jakplugg/Monsoon/README.md

# Monsoon
Monsoon Is a variation of mutable instruments clouds with separate CV and controls for the 4 "blend" functions.

12Hp eurorack module.

The 4 LEDs on the sliders indicate incoming control voltage for the 4 main parameters, this is done in hardware, with 4 LM321 op amps. 

The slider LEDs are normal "one way" and only display positive CV input, if you would prefer to see bipolar (negative as well) you can replace the rectangular LEDs in the sliders with bidirectional round 3mm red/green or any other 2 color LED, the leg spacing is the same. you simply pull up on the LEDs and they come out. (do not let cats or small children know that!)

The slider LEDs do not display slider value, just the CV input.

The button which used to select blend parameters now simply switches what the 4 LEDs display between audio input monitoring and monitoring the 4 blend amounts.

[Stock clouds, Clouds Parasites, and Jkammerl beat repeat Firmwares modified for Monsoon by Tom Burns:](https://github.com/boourns/eurorack/releases/tag/monsoon_firmwares_v1)

[Google sheet BOM (in progress):](https://docs.google.com/spreadsheets/d/1RgaPN_YdO_VuwdeUBHkcrlwIOgGYM_RJl-FyqPO2IpU/edit?usp=sharing)

JM.
