jakplugg/Monsoon/panel_key.pdf

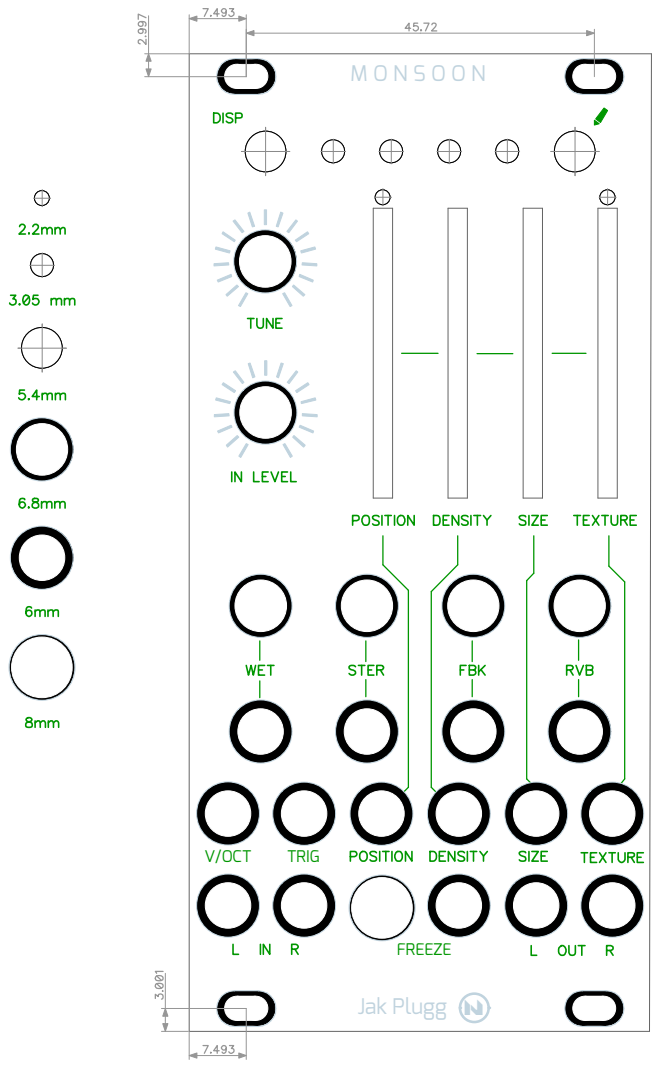
[picture p1: page 1]
Jak Plugg; V/OCT; FREEZE; TRIG
