jakplugg/Monsoon/MonsoonSheet1.pdf

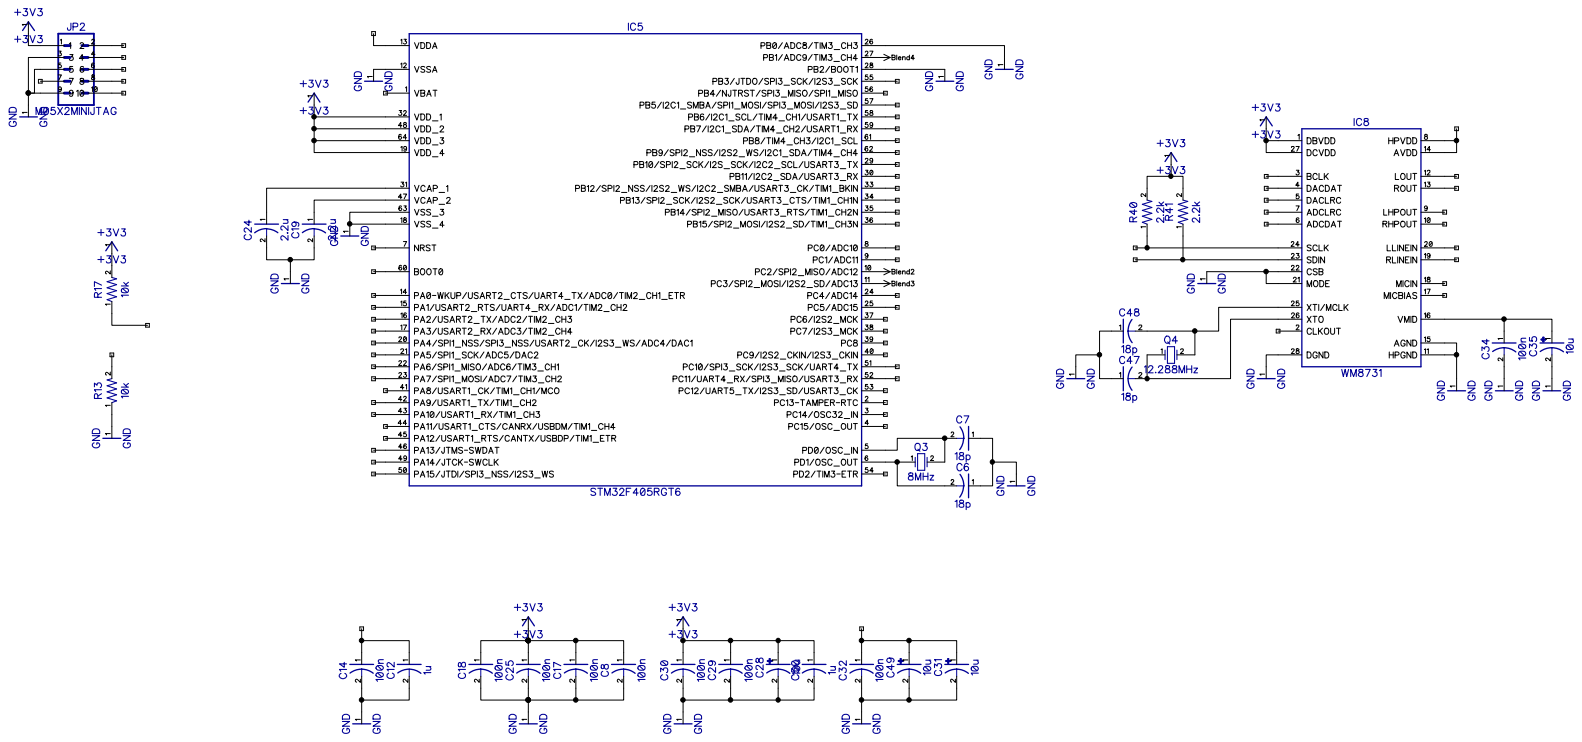
[picture p2: page 1]
