jakplugg/Monsoon/MonsoonSheet2.pdf

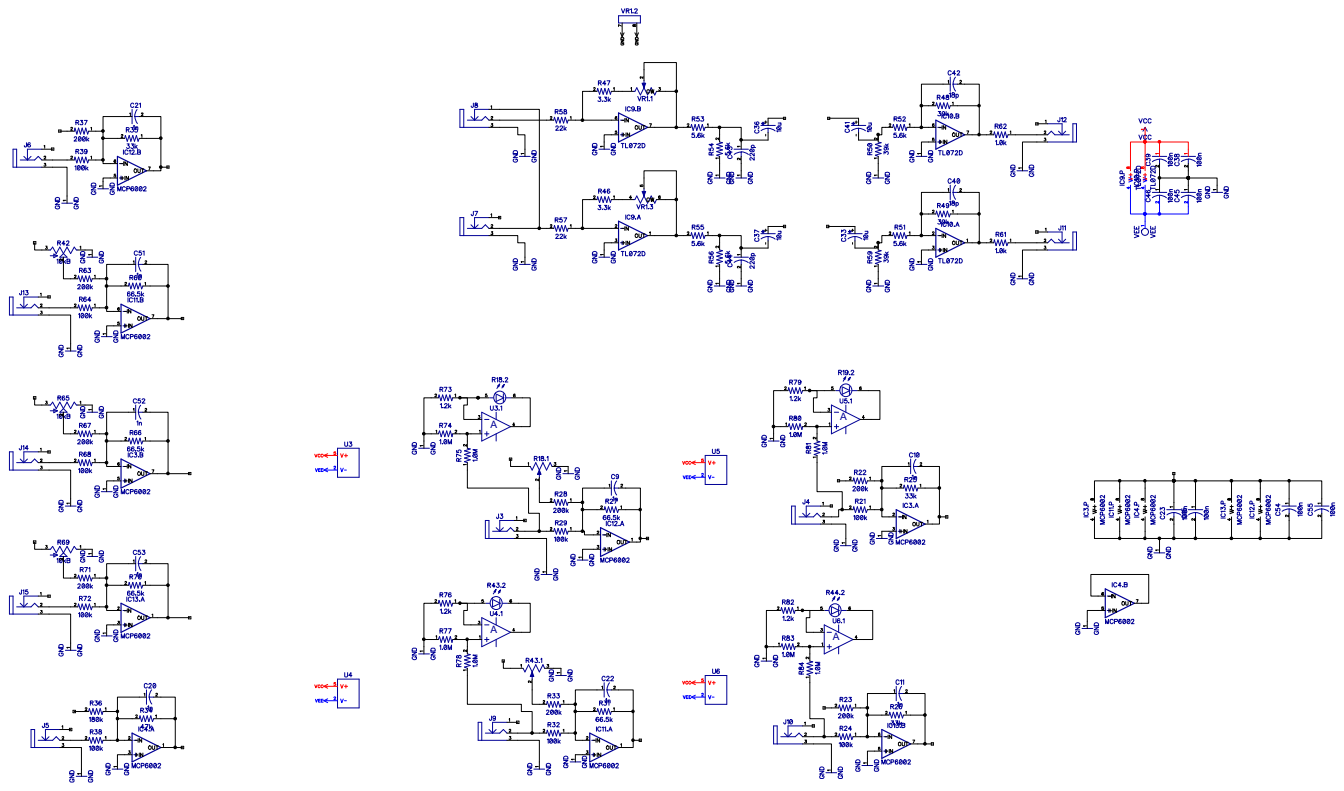
[picture p3: page 1]
