jakplugg/Monsoon/MonsoonSheet3.pdf

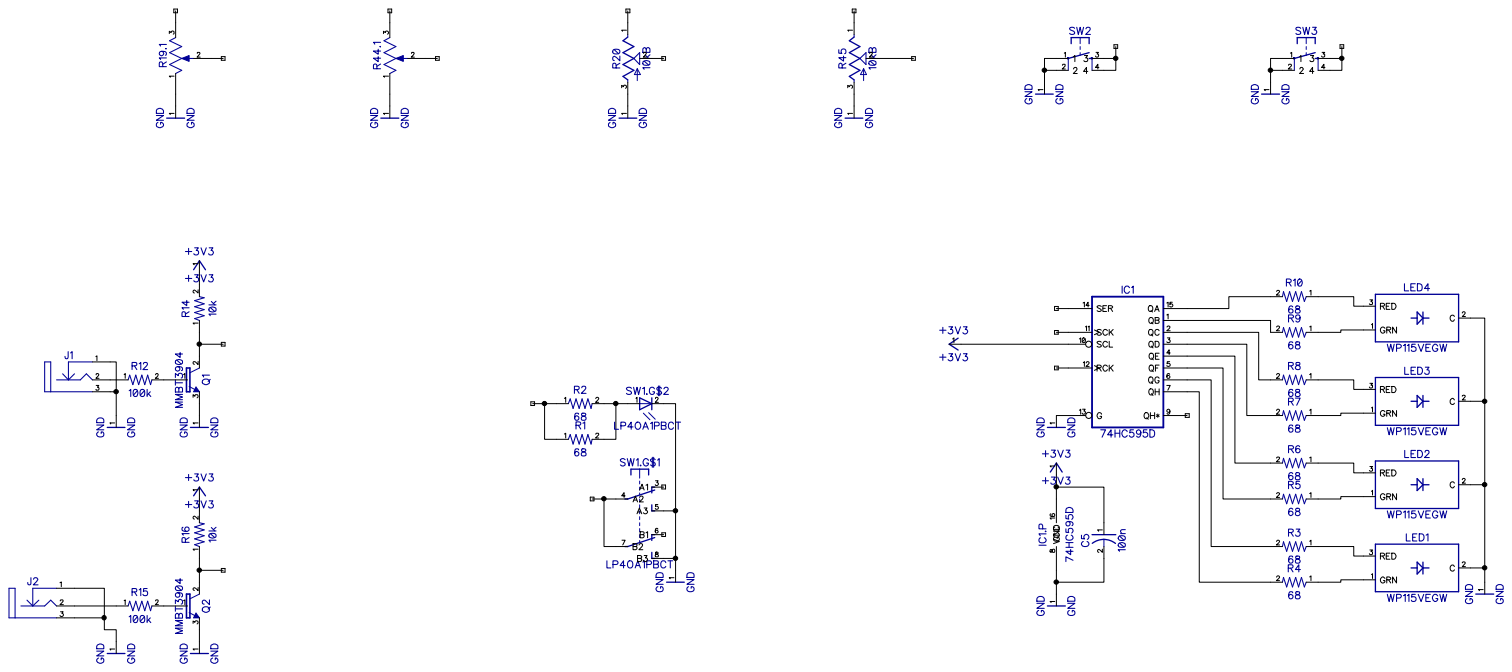
[picture p4: page 1]
