jakplugg/Monsoon/MonsoonSheet4.pdf

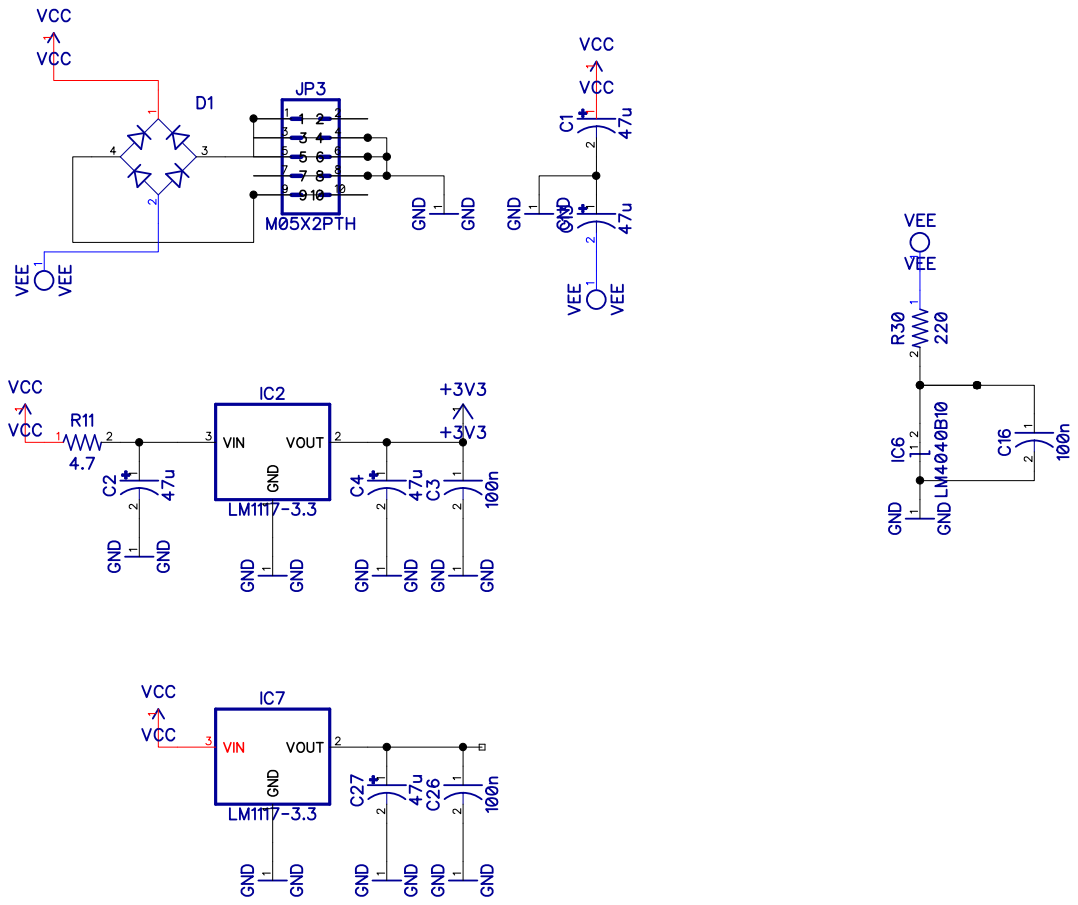
[picture p5: page 1]
