jakplugg/Monsoon/(list of files, drawings)

Other design files:
monsoon.dch
monsooon_01.dip
monsooon_panel.dip
monsooon_panel_key.dip
