jakplugg/Monsoon/eagle_export_sch.sch

## EAGLE design eagle_export_sch.sch (2018-12-09)

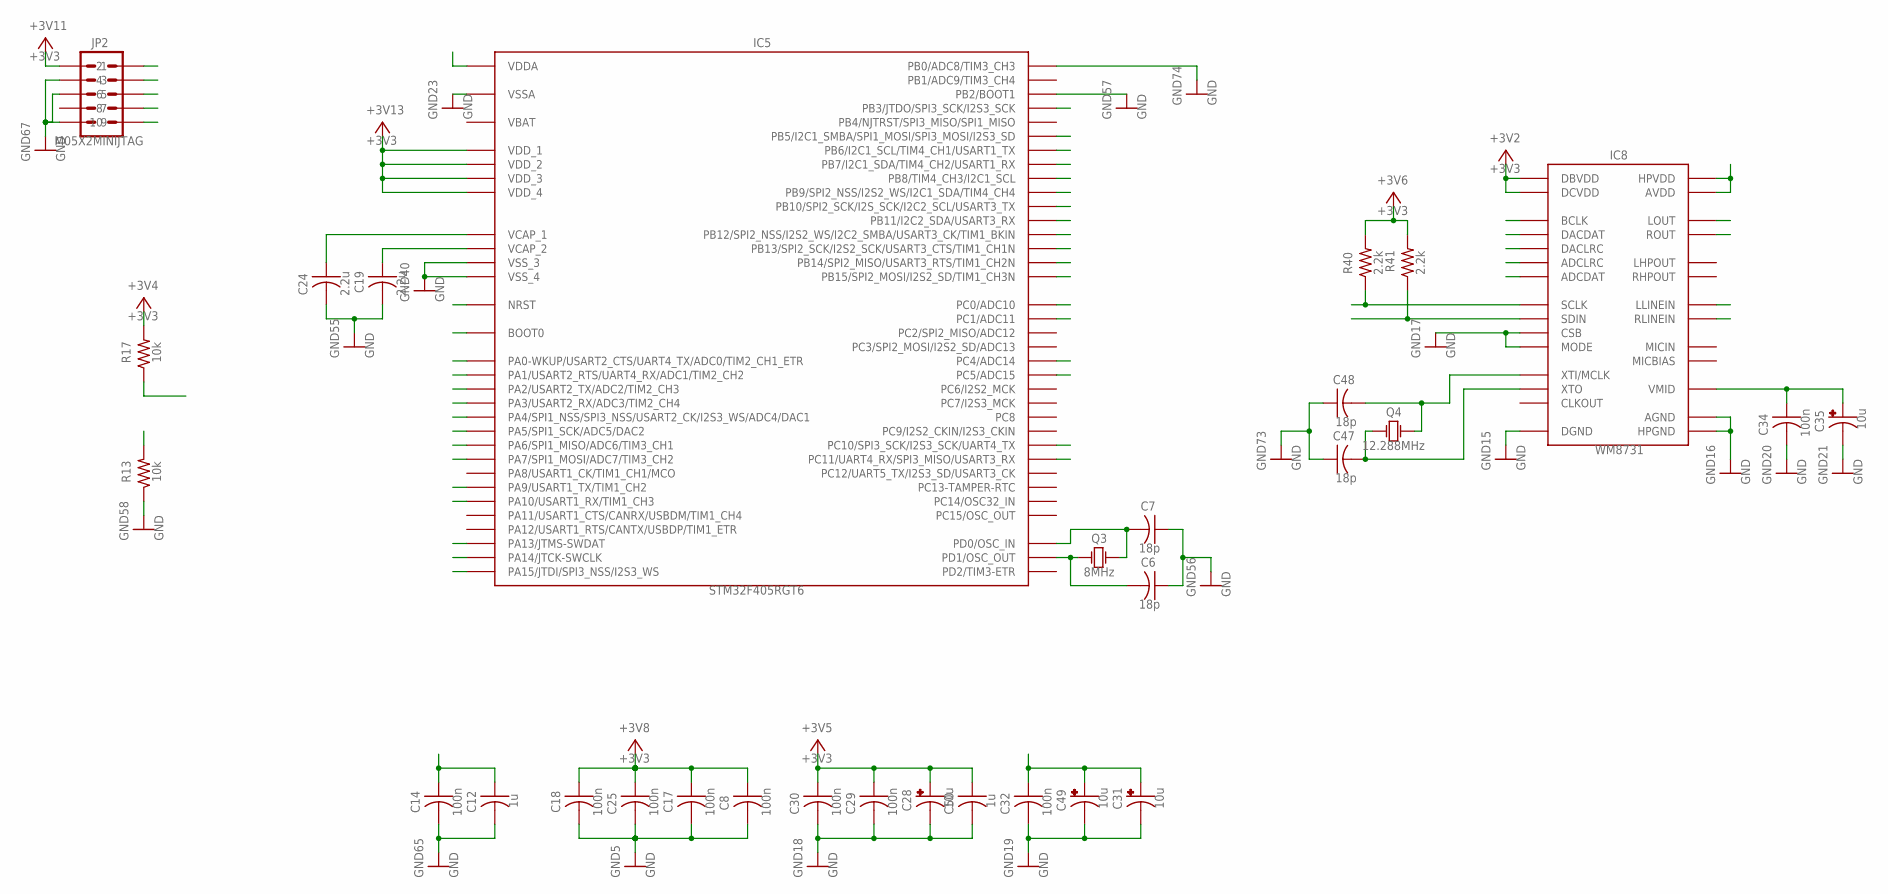
[picture p6: schematic eagle_export_sch.sch, sheet 1]

Parts:
C6, C7, C47, C48: 18p; CAP_0603
C8, C14, C17, C18, C25, C29, C30, C32, C34: 100n; CAP_0603
C12, C50: 1u; CAP_0603
C19, C24: 2.2u; CAP_0805
C28, C49: 10u; PANASONIC_A
C31, C35: 10u; PANASONIC_B
IC5: STM32F405RGT6; TQFP-10X10-64
IC8: WM8731; SSOP28
JP2: M05X2MINIJTAG; 2X5-1.27
Q3: 8MHz; TSC_7A_crystal
Q4: 12.288MHz; TSC_7A_crystal
R13, R17: 10k; RES_0603
R40, R41: 2.2k; RES_0603

Connections:
+3V3: C8.1, C17.1, C18.1, C25.1, C28.+, C29.1, C30.1, C50.1, IC5.19 (VDD_4), IC5.32 (VDD_1), IC5.48 (VDD_2), IC5.64 (VDD_3), IC8.1 (DBVDD), IC8.27 (DCVDD), JP2.1, R17.2, R40.2, R41.2
+3V3_A: C12.1, C14.1, C31.+, C32.1, C49.+, IC5.13 (VDDA), IC8.8 (HPVDD), IC8.14 (AVDD)
BLEND_CV: IC5.21 (PA5/SPI1_SCK/ADC5/DAC2)
BLEND_POT: IC5.23 (PA7/SPI1_MOSI/ADC7/TIM3_CH2)
BOOT_FLASH: IC5.60 (BOOT0), R13.2
Blend2: IC5.10 (PC2/SPI2_MISO/ADC12)
Blend3: IC5.11 (PC3/SPI2_MOSI/I2S2_SD/ADC13)
Blend4: IC5.27 (PB1/ADC9/TIM3_CH4)
DENSITY_CV: IC5.17 (PA3/USART2_RX/ADC3/TIM2_CH4)
GND: C6.1, C7.1, C8.2, C12.2, C14.2, C17.2, C18.2, C19.2, C24.2, C25.2, C28.-, C29.2, C30.2, C31.-, C32.2, C34.2, C35.-, C47.1, C48.1, C49.-, C50.2, IC5.12 (VSSA), IC5.18 (VSS_4), IC5.26 (PB0/ADC8/TIM3_CH3), IC5.28 (PB2/BOOT1), IC5.63 (VSS_3), IC8.11 (HPGND), IC8.15 (AGND), IC8.21 (MODE), IC8.22 (CSB), IC8.28 (DGND), JP2.3, JP2.5, JP2.9, R13.1
I2C_SCL: IC5.29 (PB10/SPI2_SCK/I2S_SCK/I2C2_SCL/USART3_TX), IC8.24 (SCLK), R40.1
I2C_SDA: IC5.30 (PB11/I2C2_SDA/USART3_RX), IC8.23 (SDIN), R41.1
I2S_LRCK: IC5.33 (PB12/SPI2_NSS/I2S2_WS/I2C2_SMBA/USART3_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), IC8.5 (DACLRC), IC8.7 (ADCLRC)
I2S_SCK: IC5.34 (PB13/SPI2_SCK/I2S2_SCK/USART3_CTS/TIM1_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), IC8.3 (BCLK)
I2S_SIN: IC5.35 (PB14/SPI2_MISO/USART3_RTS/TIM1_CH2N), IC8.6 (ADCDAT)
I2S_SOUT: IC5.36 (PB15/SPI2_MOSI/I2S2_SD/TIM1_CH3N), IC8.4 (DACDAT)
JTCK: IC5.49 (PA14/JTCK-SWCLK), JP2.4
JTDI: IC5.50 (PA15/JTDI/SPI3_NSS/I2S3_WS), JP2.8
JTDO: IC5.55 (PB3/JTDO/SPI3_SCK/I2S3_SCK), JP2.6
JTMS: IC5.46 (PA13/JTMS-SWDAT), JP2.2
LED_DATA: IC5.57 (PB5/I2C1_SMBA/SPI1_MOSI/SPI3_MOSI/I2S3_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)
LED_EN: IC5.24 (PC4/ADC14)
LED_REC: IC5.62 (PB9/SPI2_NSS/I2S2_WS/I2C1_SDA/TIM4_CH4)
LED_SCK: IC5.25 (PC5/ADC15)
LIN: IC8.20 (LLINEIN)
LOUT: IC8.12 (LOUT)
unnamed: C7.2, IC5.5 (PD0/OSC_IN), Q3.2 (OSC2)
unnamed: C6.2, IC5.6 (PD1/OSC_OUT), Q3.1 (OSC1)
unnamed: C19.1, IC5.47 (VCAP_2)
unnamed: C34.1, C35.+, IC8.16 (VMID)
unnamed: C24.1, IC5.31 (VCAP_1)
unnamed: C47.2, IC8.26 (XTO), Q4.1 (OSC1)
unnamed: C48.2, IC8.25 (XTI/MCLK), Q4.2 (OSC2)
PITCH_POT: IC5.9 (PC1/ADC11)
PLAY: IC5.58 (PB6/I2C1_SCL/TIM4_CH1/USART1_TX)
POSITION_POT_CV: IC5.16 (PA2/USART2_TX/ADC2/TIM2_CH3)
REC: IC5.59 (PB7/I2C1_SDA/TIM4_CH2/USART1_RX)
RESET: IC5.7 (NRST), JP2.10, R17.1
RIN: IC8.19 (RLINEIN)
ROUT: IC8.13 (ROUT)
RX: IC5.43 (PA10/USART1_RX/TIM1_CH3)
SIZE_CV: IC5.15 (PA1/USART2_RTS/UART4_RX/ADC1/TIM2_CH2)
SIZE_POT: IC5.8 (PC0/ADC10)
SW_LOAD: IC5.51 (PC10/SPI3_SCK/I2S3_SCK/UART4_TX)
SW_MODE: IC5.52 (PC11/UART4_RX/SPI3_MISO/USART3_RX)
SW_REC: IC5.61 (PB8/TIM4_CH3/I2C1_SCL)
TEXTURE_CV: IC5.14 (PA0-WKUP/USART2_CTS/UART4_TX/ADC0/TIM2_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)
TEXTURE_POT: IC5.22 (PA6/SPI1_MISO/ADC6/TIM3_CH1)
TX: IC5.42 (PA9/USART1_TX/TIM1_CH2)
V_OCT: IC5.20 (PA4/SPI1_NSS/SPI3_NSS/USART2_CK/I2S3_WS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)

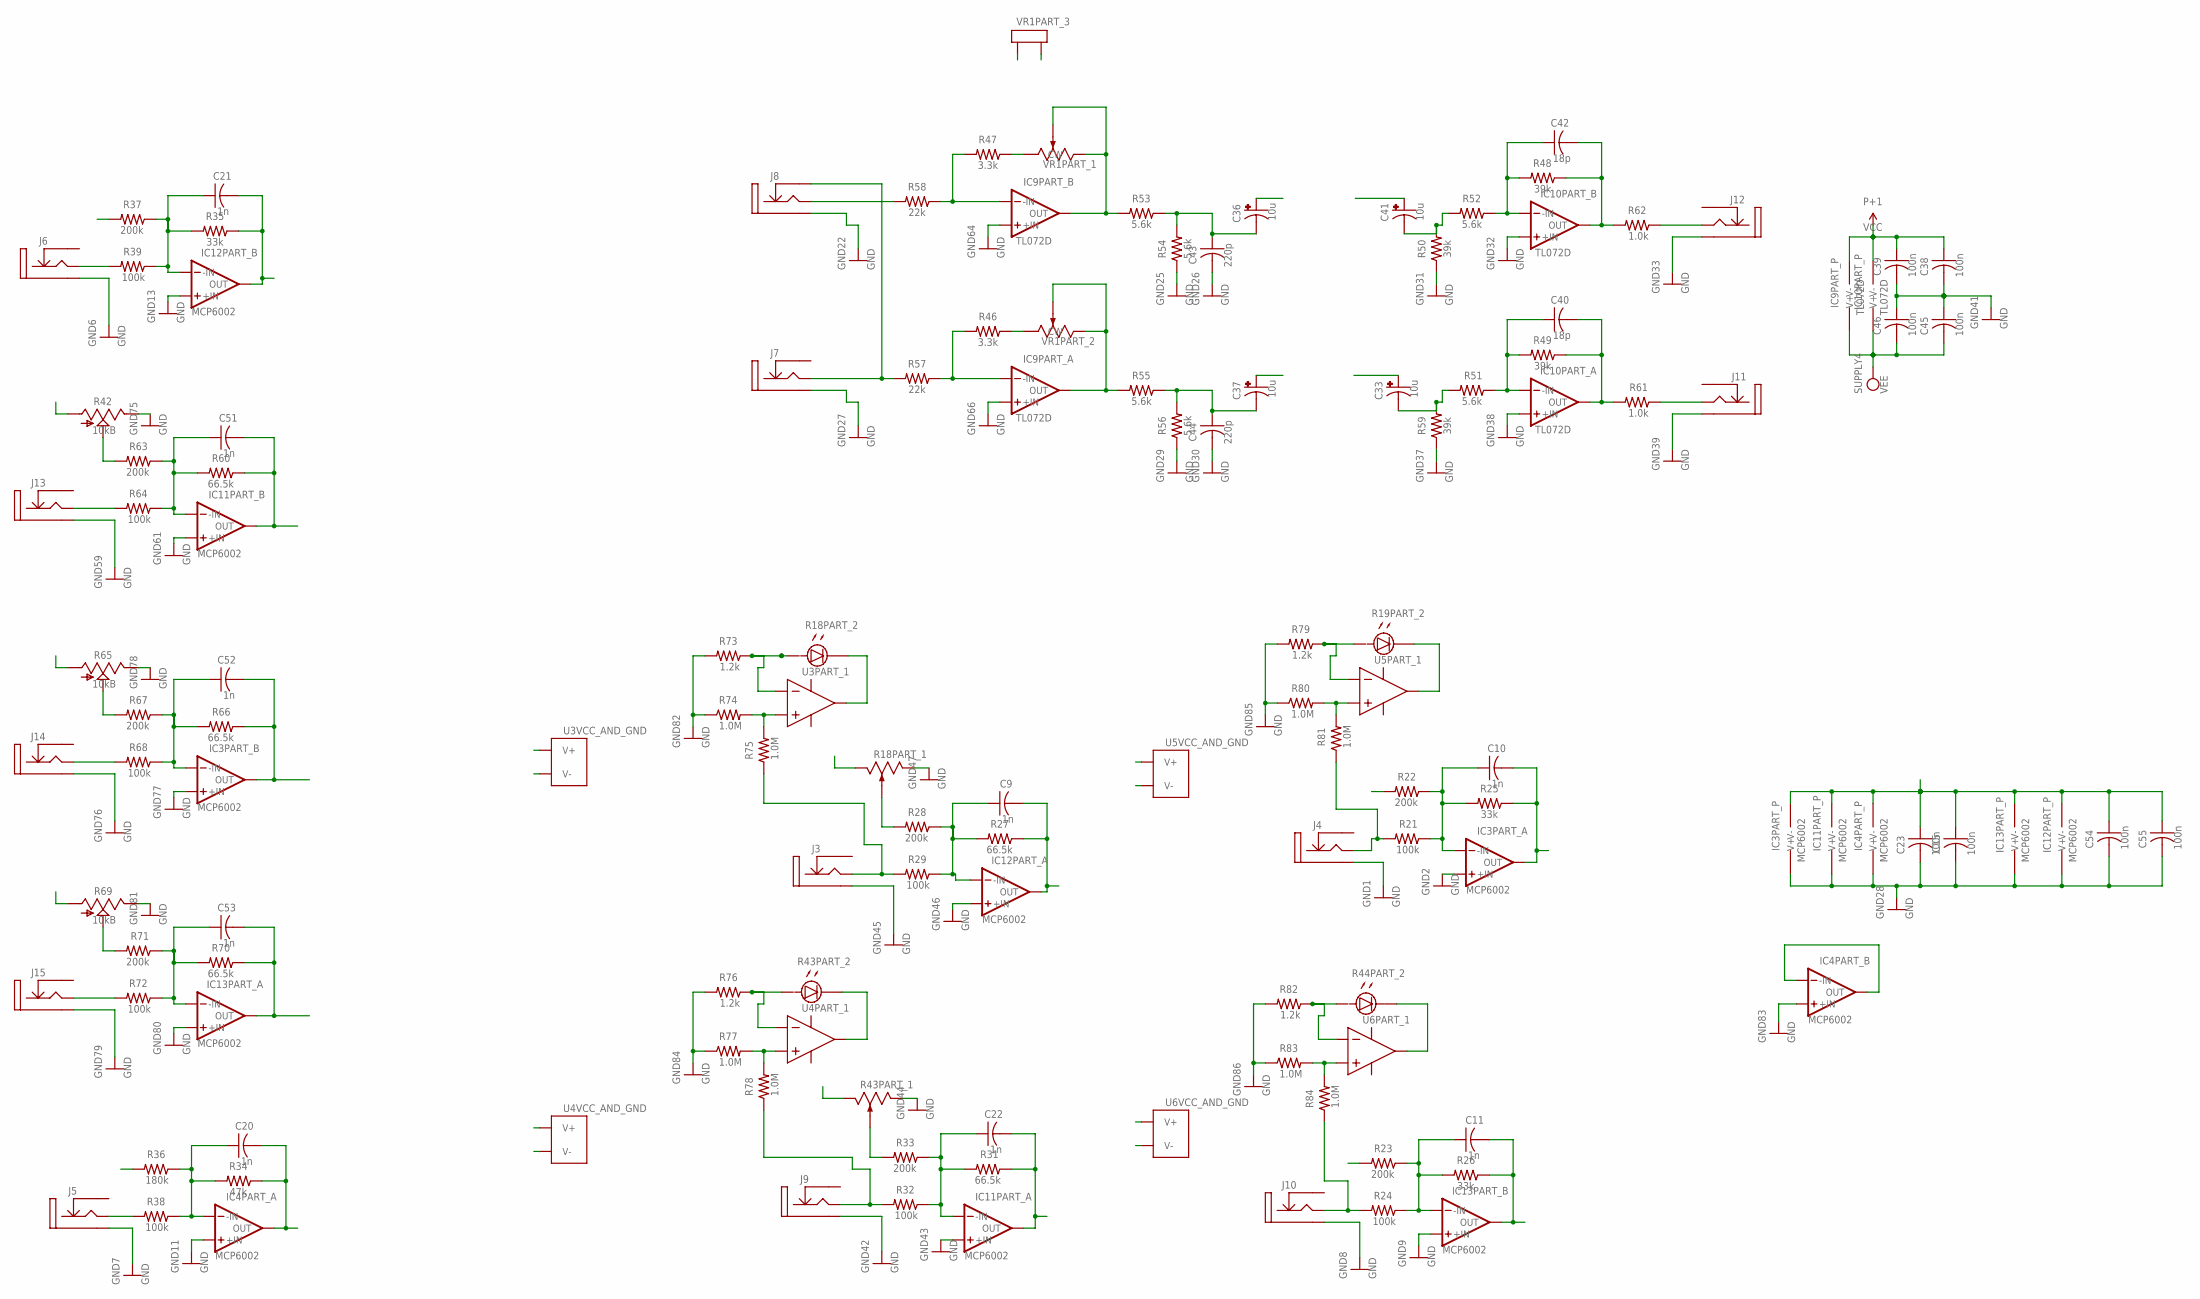
[picture p7: schematic eagle_export_sch.sch, sheet 2]

Parts:
C9, C10, C11, C20, C21, C22, C51, C52, C53: 1n; CAP_0603
C15, C23, C38, C39, C45, C46, C54, C55: 100n; CAP_0603
C33, C36, C37, C41: 10u; PANASONIC_A
C40, C42: 18p; CAP_0603
C43, C44: 220p; CAP_0603
IC3, IC4, IC11, IC12, IC13: MCP6002; SOIC-8/150mil
IC9, IC10: TL072D; SOIC-8/150mil
J3, J4, J5, J6, J7, J8, J9, J10, J13, J14, J15: THONKICONN; Thonkiconn_Jack
J11, J12: THONKICONN_33; Thonkiconn_Jack
R18, R19, R43, R44: BOURNS_PTL_LED_SLIDE_POT; BOURNS_PTL_30mm
R21, R24, R29, R32, R38, R39, R64, R68, R72: 100k; RES_0603
R22, R23, R28, R33, R37, R63, R67, R71: 200k; RES_0603
R25, R26, R35: 33k; RES_0603
R27, R31, R60, R66, R70: 66.5k; RES_0603
R34: 47k; RES_0603
R36: 180k; RES_0603
R42, R65, R69: 10kB; ALPS_POT_VERTICAL_PS
R46, R47: 3.3k; RES_0603
R48, R49, R50, R59: 39k; RES_0603
R51, R52, R53, R54, R55, R56: 5.6k; RES_0603
R57, R58: 22k; RES_0603
R61, R62: 1.0k; RES_0603
R73, R76, R79, R82: 1.2k; RES_0603
R74, R75, R77, R78, R80, R81, R83, R84: 1.0M; RES_0603
U3, U4, U5, U6: LM321MF; SOT23-5
VR1: ALPS_DUAL_POT_9MM; ALPS_dual_pot

Connections:
+3V3_A: C15.1, C23.1, C54.1, C55.1, IC3.8 (V+), IC4.8 (V+), IC11.8 (V+), IC12.8 (V+), IC13.8 (V+)
AREF_-10: R18.1 (CCW), R22.2, R23.2, R36.2, R37.2, R42.P$3 (A), R43.1 (CCW), R65.P$3 (A), R69.P$3 (A)
BLEND_CV: C21.2, IC12.7 (OUT), R35.1
Blend2: C51.2, IC11.7 (OUT), R60.1
Blend3: C52.2, IC3.7 (OUT), R66.1
Blend4: C53.2, IC13.1 (OUT), R70.1
DENSITY_CV: C22.2, IC11.1 (OUT), R31.1
GND: C15.2, C23.2, C38.2, C39.2, C43.2, C44.2, C45.1, C46.1, C54.2, C55.2, IC3.3 (+IN), IC3.4 (V-), IC3.5 (+IN), IC4.3 (+IN), IC4.4 (V-), IC4.5 (+IN), IC9.3 (+IN), IC9.5 (+IN), IC10.3 (+IN), IC10.5 (+IN), IC11.3 (+IN), IC11.4 (V-), IC11.5 (+IN), IC12.3 (+IN), IC12.4 (V-), IC12.5 (+IN), IC13.3 (+IN), IC13.4 (V-), IC13.5 (+IN), J3.3 (GND), J4.3 (GND), J5.3 (GND), J6.3 (GND), J7.3 (GND), J8.3 (GND), J9.3 (GND), J10.3 (GND), J11.3 (GND), J12.3 (GND), J13.3 (GND), J14.3 (GND), J15.3 (GND), R18.3 (CW), R42.P$1 (E), R43.3 (CW), R50.1, R54.1, R56.1, R59.1, R65.P$1 (E), R69.P$1 (E), R73.2, R74.1, R76.2, R77.1, R79.2, R80.1, R82.2, R83.1, VR1.7 (gnd), VR1.8 (gnd)
LIN: C37.+
LOUT: C33.+
unnamed: C10.1, IC3.2 (-IN), R21.1, R22.1, R25.2
unnamed: C11.1, IC13.6 (-IN), R23.1, R24.1, R26.2
unnamed: C20.1, IC4.2 (-IN), R34.2, R36.1, R38.1
unnamed: C21.1, IC12.6 (-IN), R35.2, R37.1, R39.1
unnamed: C37.-, C44.1, R55.1, R56.2
unnamed: J8.2 (Tip), R58.2
unnamed: J7.2 (Tip), J8.1 (TN), R57.2
unnamed: C36.-, C43.1, R53.1, R54.2
unnamed: C41.-, R50.2, R52.2
unnamed: C22.1, IC11.2 (-IN), R31.2, R32.1, R33.1
unnamed: C42.1, IC10.6 (-IN), R48.2, R52.1
unnamed: R33.2, R43.2 (W)
unnamed: C42.2, IC10.7 (OUT), R48.1, R62.2
unnamed: C9.1, IC12.2 (-IN), R27.2, R28.1, R29.1
unnamed: C33.-, R51.2, R59.2
unnamed: C40.1, IC10.2 (-IN), R49.2, R51.1
unnamed: C40.2, IC10.1 (OUT), R49.1, R61.2
unnamed: R18.2 (W), R28.2
unnamed: IC9.7 (OUT), R53.2, VR1.2 (W), VR1.3 (CW)
unnamed: IC9.1 (OUT), R55.2, VR1.5 (W), VR1.6 (CW)
unnamed: IC9.6 (-IN), R47.2, R58.1
unnamed: IC9.2 (-IN), R46.2, R57.1
Net_0: J13.2 (Tip), R64.2
Net_1: J14.2 (Tip), R68.2
Net_2: J15.2 (Tip), R72.2
Net_3: R43.6 (gnd), U4.4 (OUT)
Net_4: R43.5 (gnd), R76.1, U4.3 (IN-)
Net_5: R77.2, R78.2, U4.1 (IN+)
Net_6: R18.6 (gnd), U3.4 (OUT)
Net_7: R18.5 (gnd), R73.1, U3.3 (IN-)
Net_8: R19.6 (gnd), U5.4 (OUT)
Net_9: R19.5 (gnd), R79.1, U5.3 (IN-)
Net_10: R80.2, R81.2, U5.1 (IN+)
Net_11: R44.6 (gnd), U6.4 (OUT)
Net_12: R44.5 (gnd), R82.1, U6.3 (IN-)
Net_13: R83.2, R84.2, U6.1 (IN+)
Net_24: J12.2 (Tip), R62.1
Net_26: J9.2 (Tip), R32.2, R78.1
Net_28: J5.2 (Tip), R38.2
Net_32: J6.2 (Tip), R39.2
Net_36: J10.2 (Tip), R24.2, R84.1
Net_46: R74.2, R75.2, U3.1 (IN+)
Net_50: J3.2 (Tip), R29.2, R75.1
Net_75: R47.1, VR1.1 (CCW)
Net_76: R46.1, VR1.4 (CCW)
Net_92: J11.2 (Tip), R61.1
Net_105: J4.2 (Tip), R21.2, R81.1
Net_106: C52.1, IC3.6 (-IN), R66.2, R67.1, R68.1
Net_107: C51.1, IC11.6 (-IN), R60.2, R63.1, R64.1
Net_114: R42.P$2 (S), R63.2
Net_115: R65.P$2 (S), R67.2
Net_116: R69.P$2 (S), R71.2
Net_117: C53.1, IC13.2 (-IN), R70.2, R71.1, R72.1
Net_118: IC4.6 (-IN), IC4.7 (OUT)
POSITION_POT_CV: C9.2, IC12.1 (OUT), R27.1
RIN: C36.+
ROUT: C41.+
SIZE_CV: C10.2, IC3.1 (OUT), R25.1
TEXTURE_CV: C11.2, IC13.7 (OUT), R26.1
VCC: C38.1, C39.1, IC9.8 (V+), IC10.8 (V+), U3.5 (V+), U4.5 (V+), U5.5 (V+), U6.5 (V+)
VEE: C45.2, C46.2, IC9.4 (V-), IC10.4 (V-), U3.2 (V-), U4.2 (V-), U5.2 (V-), U6.2 (V-)
V_OCT: C20.2, IC4.1 (OUT), R34.1

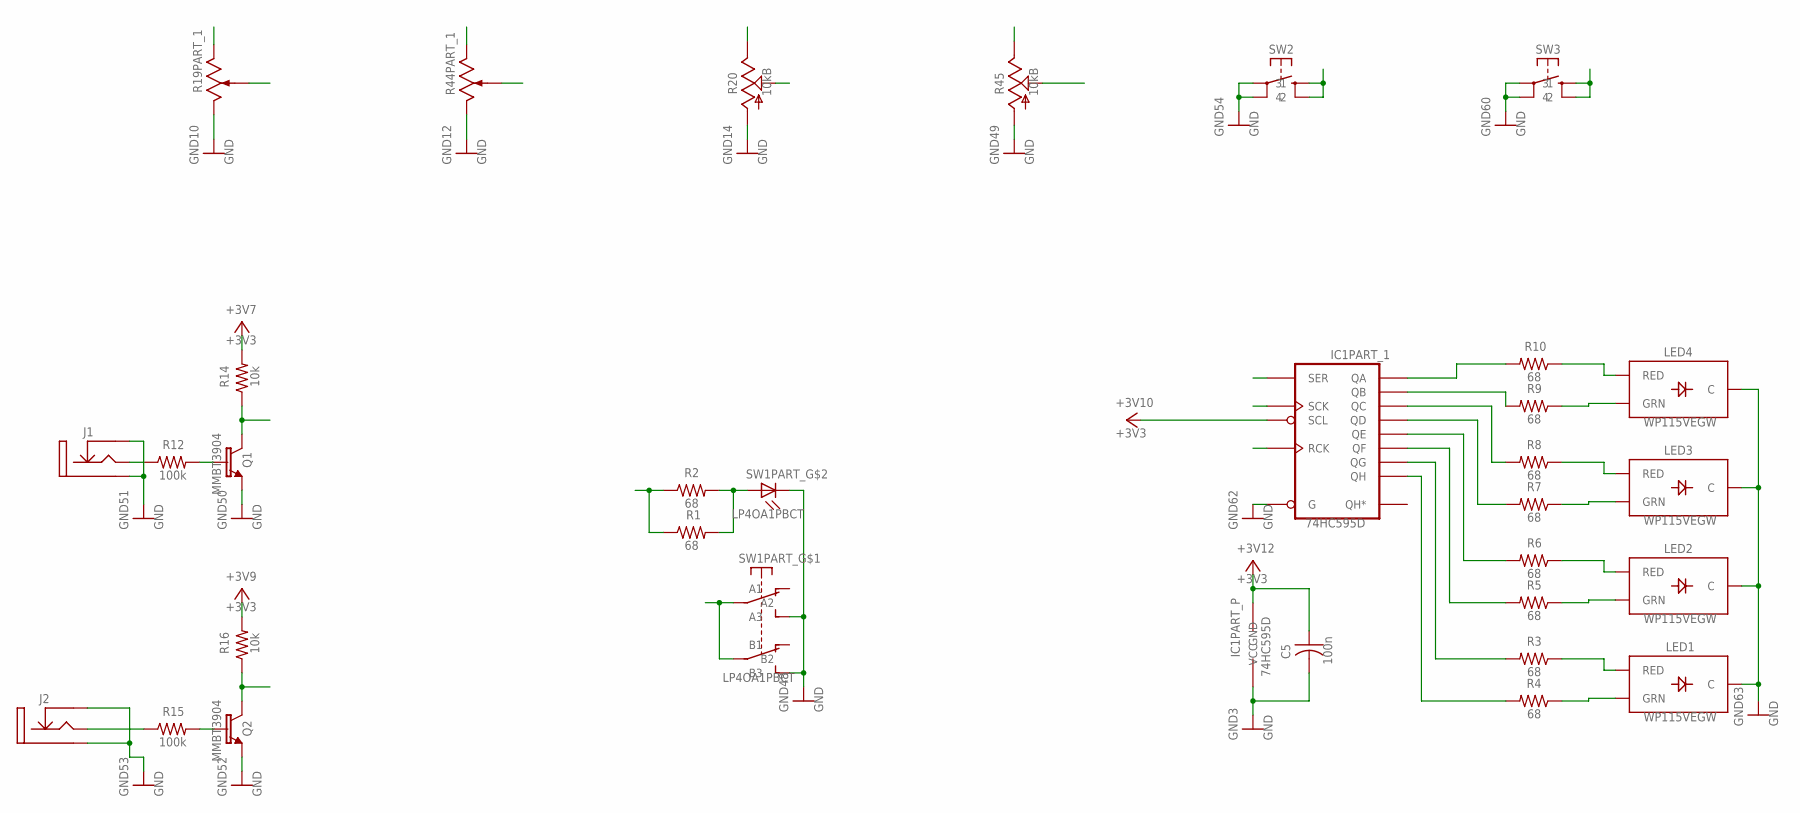
[picture p8: schematic eagle_export_sch.sch, sheet 3]

Parts:
C5: 100n; CAP_0603
IC1: 74HC595D; SO16
J1, J2: THONKICONN; Thonkiconn_Jack
LED1, LED2, LED3, LED4: WP115VEGW; LED-BICOLOR-THROUGHHOLE
Q1, Q2: MMBT3904; SOT23-BEC
R1, R2, R3, R4, R5, R6, R7, R8, R9, R10: 68; RES_0603
R12, R15: 100k; RES_0603
R14, R16: 10k; RES_0603
R19, R44: BOURNS_PTL_LED_SLIDE_POT; BOURNS_PTL_30mm
R20, R45: 10kB; ALPS_POT_VERTICAL_PS
SW1: LP4OA1PBCT
SW2, SW3: TAC_SWITCHPTH; TACTILE-PTH

Connections:
+3V3: C5.1, IC1.10 (SCL), IC1.16 (VCC), R14.2, R16.2
+3V3_A: R19.3 (CW), R20.P$1 (E), R44.3 (CW), R45.P$1 (E)
BLEND_POT: R45.P$2 (S)
GND: C5.2, IC1.8 (GND), IC1.13 (G), J1.1 (TN), J1.3 (GND), J2.1 (TN), J2.3 (GND), LED1.2 (C), LED2.2 (C), LED3.2 (C), LED4.2 (C), Q1.E, Q2.E, R19.1 (CCW), R20.P$3 (A), R44.1 (CCW), R45.P$3 (A), SW1.L2, SW1.P3 (A3), SW1.P6 (B3), SW2.1, SW2.2, SW3.1, SW3.2
LED_DATA: IC1.14 (SER)
LED_EN: IC1.12 (RCK)
LED_REC: R1.1, R2.1
LED_SCK: IC1.11 (SCK)
unnamed: Q2.B, R15.2
unnamed: R1.2, R2.2, SW1.L1
unnamed: IC1.15 (QA), R10.2
unnamed: IC1.1 (QB), R9.2
unnamed: IC1.2 (QC), R8.2
unnamed: IC1.3 (QD), R7.2
unnamed: IC1.4 (QE), R6.2
unnamed: IC1.5 (QF), R5.2
unnamed: IC1.6 (QG), R3.2
unnamed: IC1.7 (QH), R4.2
unnamed: Q1.B, R12.2
Net_31: LED4.3 (RED), R10.1
Net_34: LED4.1 (GRN), R9.1
Net_38: LED3.3 (RED), R8.1
Net_51: LED3.1 (GRN), R7.1
Net_56: LED2.3 (RED), R6.1
Net_59: J2.2 (Tip), R15.1
Net_61: LED2.1 (GRN), R5.1
Net_62: LED1.3 (RED), R3.1
Net_63: LED1.1 (GRN), R4.1
Net_78: J1.2 (Tip), R12.1
PITCH_POT: R20.P$2 (S)
PLAY: Q2.C, R16.1
REC: Q1.C, R14.1
SIZE_POT: R19.2 (W)
SW_LOAD: SW3.3, SW3.4
SW_MODE: SW2.3, SW2.4
SW_REC: SW1.P2 (A2), SW1.P5 (B2)
TEXTURE_POT: R44.2 (W)

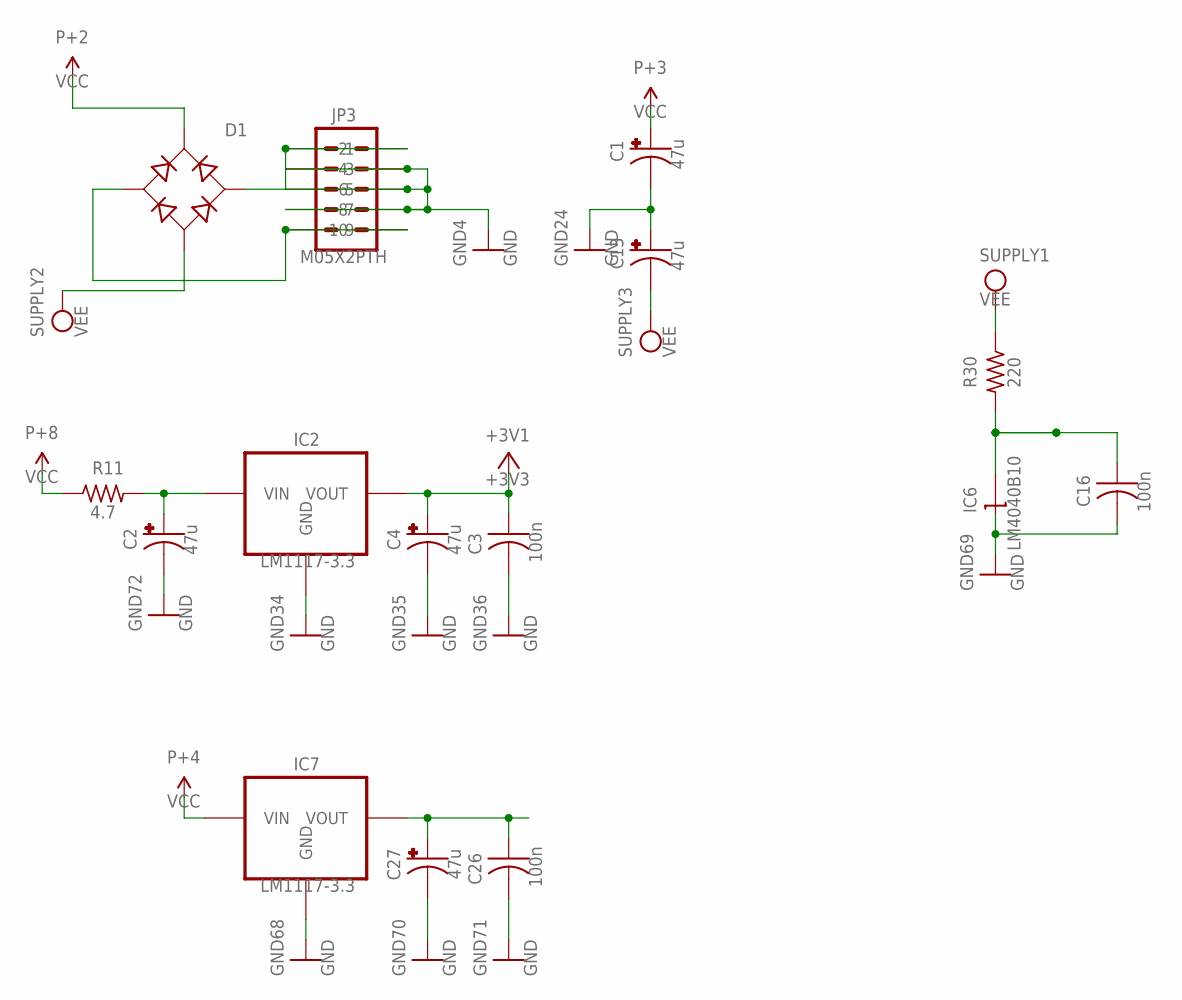
[picture p9: schematic eagle_export_sch.sch, sheet 4]

Parts:
C1, C2, C4, C13, C27: 47u; CAPAE-5.3x5.3h7
C3, C16, C26: 100n; CAP_0603
D1: MB1S; SOP-4/6.5x2.54
IC2: LM1117-3.3; SOT223-4
IC6: LM4040B10; DBZ_R-PDSO-G3
IC7: LM1117-3.3; SOT223
JP3: M05X2PTH; AVR_ICSP
R11: 4.7; R1206
R30: 220; RES_0603

Connections:
+3V3: C3.1, C4.1 (+), IC2.2 (VOUT)
+3V3_A: C26.1, C27.1 (+), IC7.2 (VOUT)
AREF_-10: C16.1, IC6.2 (A), R30.2
GND: C1.2 (-), C2.2 (-), C3.2, C4.2 (-), C13.1 (+), C16.2, C26.2, C27.2 (-), IC2.1 (GND), IC6.1 (C), IC7.1 (GND), JP3.3, JP3.4, JP3.5, JP3.6, JP3.7, JP3.8
unnamed: C2.1 (+), IC2.3 (VIN), R11.2
unnamed: D1.3 (AC2), JP3.1, JP3.2
unnamed: D1.4 (AC1), JP3.9, JP3.10
VCC: C1.1 (+), D1.1 (+), IC7.3 (VIN), R11.1
VEE: C13.2 (-), D1.2 (-), R30.1
