jakplugg/Monsoon/(threads)

Thread 1 (2019-03-17):

R30 Value

LennyHelton, 2019-03-17:
Should R30 value be 220R or 470R?  The value in the BOM is listed as 220R but Mouser reference is for 470R.  DIP file indicates 470R as well.

KittenVillage, 2019-05-25:
I noticed the same thing. I think when in doubt, go with the diptrace?

jakplugg, 2019-10-09:
Sorry, it is 220R because the monsoon draws more current from the voltage reference than the original clouds and uburst.

Thread 3 (2020-01-13):

For flashing, do I need power from both PSU and ST-Link?

suit4, 2020-01-13:

suit4, 2020-01-13:
It looks like there already is a connection between the Eurorack power header and the JTAG pin for 3.3V.

Do I need to connect both PSU to power header and ST-Link (clone) power line to JTAG power pin?

Or is power via JTAG header sufficient?

AfterLaterAudio, 2020-01-13:
You need power through the power headers while flashing.

suit4, 2020-01-16:
Yup. That worked nicely. Thanks

Closed 2020-01-16.

Thread 4 (2021-08-28):

R73, R76, R79, R82 value?

01tot10, 2021-08-28:
Hey!

The BOM says 1.2k for R73, R76, R79, R82 but without Mouser reference, while on the schemo they're marked as 330R.
What would be there right value there? I'm leaning towards 330R here since they are for the LEDs.

jakplugg, 2021-08-28:
It's up to your LED brightness preference, but i would go with 1.2k to
start with.

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

01tot10, 2021-08-29:
Thanks for the quick reply! Oh, my intuition was guiding me wrong then. Somehow it sounded like a large value for controlling the LEDs. Thanks for clearing that out, I'll close the issue.

Closed 2021-08-29.

Thread 6 (2025-07-20):

Firmware update issue

olka, 2025-07-20:
Hi!
Have some unpleasant problem after firmware update.
So I’ve downloaded and flashed Kammerl Firmware 0.42 from kammerl.de and Monsoon worked fine. But after restart all LEDs are yellow and Freeze LED doesn’t glow.
Tried flashing it again with the same process but nothing happened.
Any tips how to fix it?
