jakplugg/Monsoon/(commit log)

2018-11-09 add bom
2018-11-09 readme
    added text about LEDs
2018-12-01 update BOM
2018-12-09 upload schematic
    diptrace schematic and smeagle export
    [eagle_export_sch.sch, monsoon.dch]
2019-01-02 general release files
    upload main files
    [monsooon_01.DRL, monsooon_01.GBL, monsooon_01.GBO, monsooon_01.GBP, monsooon_01.GBS, monsooon_01.GKO, monsooon_01.GTL, monsooon_01.GTO]
2019-01-12 panel text
    fixed panel text alignment
    [monsooon_panel.GBL, monsooon_panel.GBS, monsooon_panel.GTL, monsooon_panel.GTO, monsooon_panel.GTS]
2019-02-12 oploaded PDFs
    [export_eagle_panel.brd]
2019-03-20 changed values
    changed values of LED resistors and VREF resistors to match BOM
    [monsoon.dch, monsooon_01.dip]
